RespiraWorks/KiCad-Library/README.md

# KiCad-Library
Repository for containing RespiraWorks' electrical KiCad Library

"RespiraWorks_Std" libraries contain lightly-modified or unmodified copies of symbols or footprints from the KiCAD standard library  
"RespiraWorks" libraries contain components created from scratch
