RespiraWorks/KiCad-Library/(commit log)

2020-11-14 Initial check-in from personal library
    Added many standard footprints, modified for slightly better appearance on assembly drawings
2020-11-14 Added files for KiCAD setup
    Added shortcut key files for schematic, layout editor
    Added BOM config file for KiBOM plugin
2020-11-16 Delete LICENSE
    deleting license file it switch to CC-BY-SA-4.0 to comply with KiCad library license
2020-11-21 Renamed libraries, merged
    Moved footprints from KiCAD standard libraries to RespiraWorks_Std
    Merged Edwin and Steph's new schematic symbols
    Added pressure sensor schematic symbols
2020-11-22 Added pressure sensor footprints, standard footprints
    Copied and modified 2920-size fuse and Keystone 5019 testpoint to _Std lib
    Created pressure sensor footprints
2020-11-28 steph footprints
2020-11-30 added group 1 footprints LEDs, fuse holder, SMD switch
2020-12-13 Additions for schem work
    Added various footprints and symbols needed for 5V buck regulator, solenoid driver, ST-Link programmer
    Moved a couple symbols based off of KiCAD library from RespiraWorks to RespiraWorks_Std
    Marked backup files (*.bck) to be ignored
2020-12-15 Power flags, crystal, jumpers
    Added power flags to schematic lib
    Copied crystal footprint to footprint lib
    Copied solder jumpers (NC and NO) to footprint lib
2020-12-17 added RPI connector symbol
2020-12-21 added BQ25713 battery charge controller
2020-12-21 Misc. parts
    Added TLC555, LD39050 (LDO) to schematic lib
    Added DFN-6 (for LD39050) to footprint lib
    Fixed missing assy-drawing reference in buzzer's footprint (CT-1205...)
2020-12-21 Batt manager footprint
    Changed bq... footprint to reference RespiraWorks_Std library, copied this footprint to RespiraWorks_Std and standard-ified it
2020-12-21 Pin naming
    Fixed active-low pin naming in a couple symbols
    (KiCAD automatically rearranged the order of a couple symbols but kept content intact)
2020-12-24 added FETs for battery controller
2020-12-25 sd card and power ports
2021-01-09 Footprints for sensor daughterboards
    Added 1x3 male header through-hole (from std libs) to Std
    Added 1x3 female header SMT back-entry (modified heavily from std libs) to Std
2021-01-09 Copied Micro-Fit connectors for sensors to Std
2021-01-10 LED update, new crystal and connectors
    Copied in 1x5 Molex Micro-Fit
    Added crystal footprint (ABS05)
    Added minor improvements to LED 3528 footprints
2021-01-10 Molex + daughterboard connections
    Copied Molex MicroFit 1x4 footprint
    Added symbol and footprint for sensor daughterboard mechanical connections
2021-01-10 Battery holder
    Created coin cell battery holder footprint for RTC
2021-01-11 added 3.3V reference for ADC128D818
2021-01-11 New power symbol, more headers
    Added +5V_Sns power symbol
    Copied in symbols for 1x4 male and female 0.1" headers
2021-01-22 added 2512 footprint
2021-01-22 adding megafit connectors for the power section
2021-01-24 Cleanup to match new rules
    Added ADC128D818 symbol to _Std
    Changed a couple "Part Number" fields to "Manufacturer PN" to match new naming rules
    Added descriptions to symbols missing them
    Added "Manufacturer" and/or "Manufacturer PN" fields to parts with unambiguous ordering info
2021-01-24 Cleanup, Raspberry Pi
    Added descriptions to footprints missing them
    Unified reference text sizes for some footprints where needed
    Added extra pin numbering markings on some _Std connectors, SMT polarized cap to bring in line with the rest
    Added Raspberry Pi attachment footprint, symbol
2021-01-24 Pressure sensor daughterboard shrink
    Shrunk pressure sensor daughterboard from 40x40 mm to 42x25 mm to save PCB space, requiring MPX5100 to be mounted vertically
    Changed " hole size from #4/M3 to M2.5/#2 to match Raspberry Pi
2021-01-30 Cleanup, Arduino headers
    Cleaned up markings/naming on Abracon ABS25 footprint, 2x20 male header
    Added female headers (sockets) for Arduino shield connections
2021-01-30 Fixed 1206
    Changed silkscreen reference size on 1206 resistor to be consistent with all other parts
2021-01-30 STM32L496 symbol
    Copied STM32L496RETx/RGTx symbol into RespiraWorks_Std
2021-02-01 Fixed SD card connector
    Changed name of 503... to make function more explicit and match naming of other parts
    Fixed incorrect layer assignments in SD card footprint
    Fixed missing "detect" pin in SD card footprint
    Cleaned up drawings in SD card footprint
2021-02-03 added BQ24773 battery charger
2021-02-05 added schematic symbols for MAX17320 battery fuel gauge / balancer
2021-02-07 2x20 connectors
    Added 2x20 female (PinSocket)
    Fixed 2x20 male (PinHeader)
2021-02-09 New battery-controller footprints, cleanup
    Added a few QFN and a VSON footprint for battery controller components
    Cleaned up existing QFNs
    Added SPM12565VT inductor footprint for battery comtroller
    Cleaned up misc. existing
2021-02-09 adding 10A littelfuse fuse with holder omniblok 154
2021-02-12 updated with parts for battery controller
2021-02-12 added SRP1038 footprint
2021-02-13 added 30V PFET for battery charger
2021-02-15 powerstep01 cleanup
    Split into two sections with VS and everything else
    Moved VBOOT pin to a more logical place next to CP
    Corrected the wrong-polarity inversion on SYNC (pin 15)
    Added footprint reference
2021-02-15 powerstep01 cleanup (cont.)
    Oops
2021-02-21 Added VLink power symbol
2021-03-04 Added 8mm polarized-SMT cap footprint
2021-03-05 Copied in JST battery connector, net tie footprints
2021-03-05 Removed duplicate +5V-RPi to prevent confusion
2021-03-06 added STM32L496VGT drop in extension to STM32L496RET
2021-03-06 moved VREF+/- pins slightly in STM32L496VGT to make schematic cleaner.
2021-03-06 added symbol and footprint for Bel Fuse 2920 format PTC polyfuse
2021-03-06 Created replacement symbol for L6470PD to replace powerSTEP01 due to availability issues, footprint is WIP
2021-03-06 add LQFP-100_14x14mm_P0.5mm.kicad_mod to std
2021-03-07 New _Std footprints
    Copied in 0805-size cap, 1812-size fuse, USB mini-B connector
    Mirrored the SMT vertical header (for pressure sensor daughterboards) to match available parts
    Edited pushbutton footprint to match available parts
2021-03-07 powerso36 footprint complete
2021-03-07 Stephanie fixes
    Added missing pin 7 to BMP280
    Corrected pin naming etc. on LM4120
2021-03-08 changed EPAD designator on the powerSO-36 footprint
2021-03-08 Copied in 3x3 PowerDI3333 package
2021-03-09 added SGD versions of NMOS and PMOS symbols, added 3.3x3.3 VSON footprint in SGD format
2021-03-10 Level shifter footprint fix, misc. cleanup
    Copied in SSOP-8_2.95x2.8_P0.65mm footprint and corrected its overly long, thin pads
    Changed SN74LVC2T45... to point to this correct footprint
    Adjusted some fab-layer references which were too small/large/thick
2021-03-12 adding missing 1x8 molex micro-fit footprint
2021-03-13 adding connectors and fuses for floorplanning
2021-03-14 SMT heatsink footprints
2021-03-14 Heatsink symbol from std lib
2021-03-24 3D model fixes, added mounting hole
2021-03-26 fix mech hole sizes, add 3d links
2021-03-27 No thermal reliefs for thermal vias
    Changed connection types from "from parent footprint" to "solid" on all thermal vias/bottom-layer thermal pads embedded in footprints
2021-03-28 Cleanup
    Removed an old intermediate footprint
    Fixed consistency of inductor footprint names
    Fixed text size is 2512 resistor footprint
2021-03-30 DRC fixes
    Shrunk pad height of VSON-8 from 0.5 mm to 0.49 mm (and regularized spacing) to fit 6 mil/0.153 mm clearance
    Removed courtyard on stm32shield and moved F.Fab drawings to Dwgs.User
    Made silkscreen references invisible on BeMicro, stm32shield, as non-real components
2021-03-30 Tweaks for BOM, mfg files
    Adjusted KiBOM config file
    Adjusted footprints for clearer appearance on assembly drawing
2021-04-01 Pressure sensor + daughterboard connector
    Added more-available connector footprint for pressure sensor daughterboard
    Removed silkscreen from off-board sections of pressure sensor footprints
    Made vertical "prototyping only" footprint for MPXV5700 for small board size
2021-04-01 Fixed female SMT headers
    Added missing pin on F.Fab on 1x4 SMT female headers
2021-04-07 Fixed connector 3D model direction
